fakedna/18650/(commit log)

2026-09-22 Revise README for Li-ion Battery Charger project
    Updated project description and added details about components, circuit diagram, and breadboard layout.
2026-09-22 Rename 'Breadboard' section to 'Wiring diagram'
2026-09-23 Update README with features and current specifications
    Added features list and clarified max charge/discharge current.
2026-09-23 Update resistor ratings and power unit input range
2026-09-23 Update max charge current in README
2026-09-23 Clarify MOSFET and INA module descriptions in README
2026-09-23 Clarify channel switch button and add important notes
2026-09-23 Update README with new battery cycle features
2026-09-23 Fix typo in circuit diagram section
